Jvscopel27/Water-Tank-monitor/hardware/circuito.png

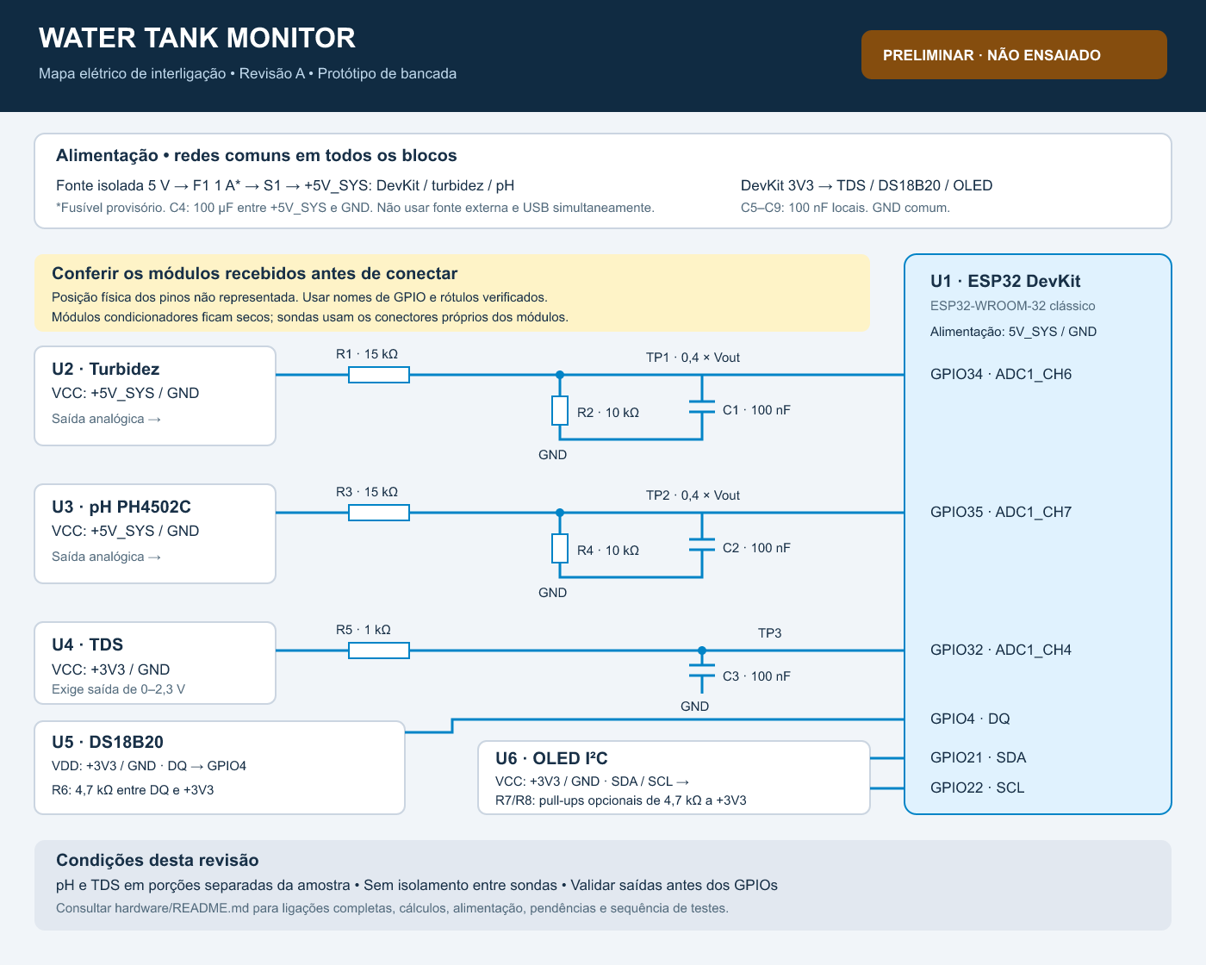
hardware/circuito.png
