Jvscopel27/Water-Tank-monitor/frame/PROJETO PIC.stl

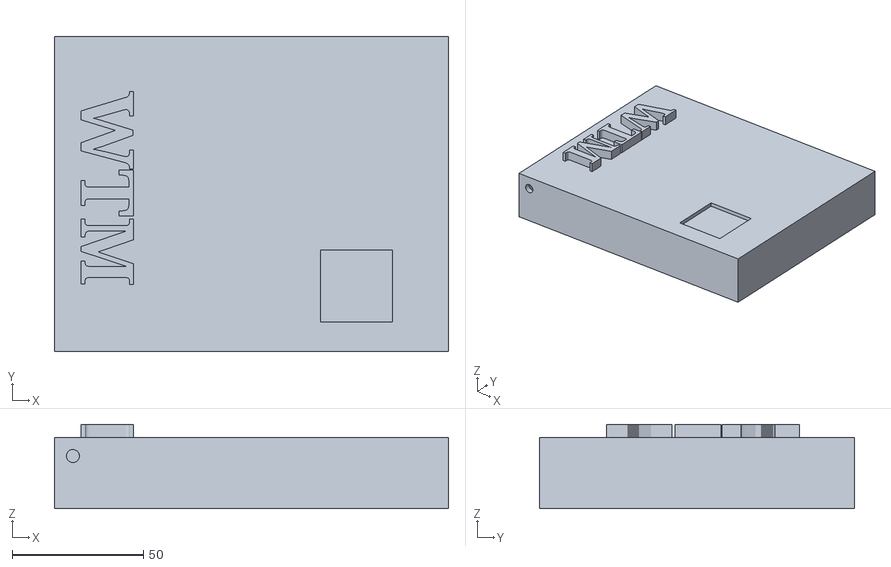
[picture p6: CAD file, 2026-10-22]
frame/PROJETO PIC.stl
150.0 x 120.0 x 32.0
