Jvscopel27/Water-Tank-monitor/Part Studio 1 - tampa.step

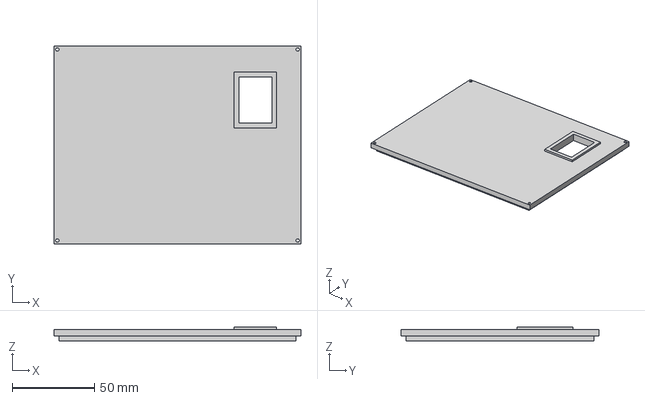
[picture p7: CAD file, 2026-11-10]
Part Studio 1 - tampa.step
150.0 x 120.0 x 8.50 mm
