Jvscopel27/Water-Tank-monitor/Part Studio 1 - caixa.step

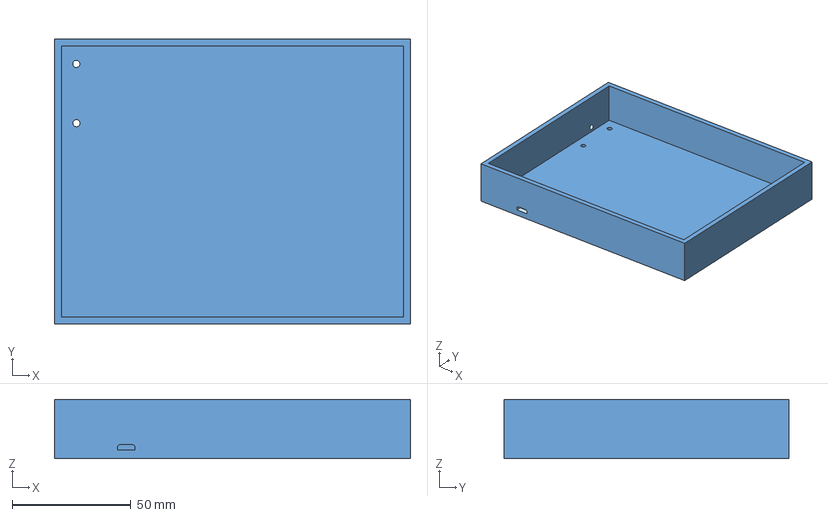
[picture p8: CAD file, 2026-11-10]
Part Studio 1 - caixa.step
150.0 x 120.0 x 25.0 mm
