Jvscopel27/Water-Tank-monitor/frame/Prototipo1.pdf

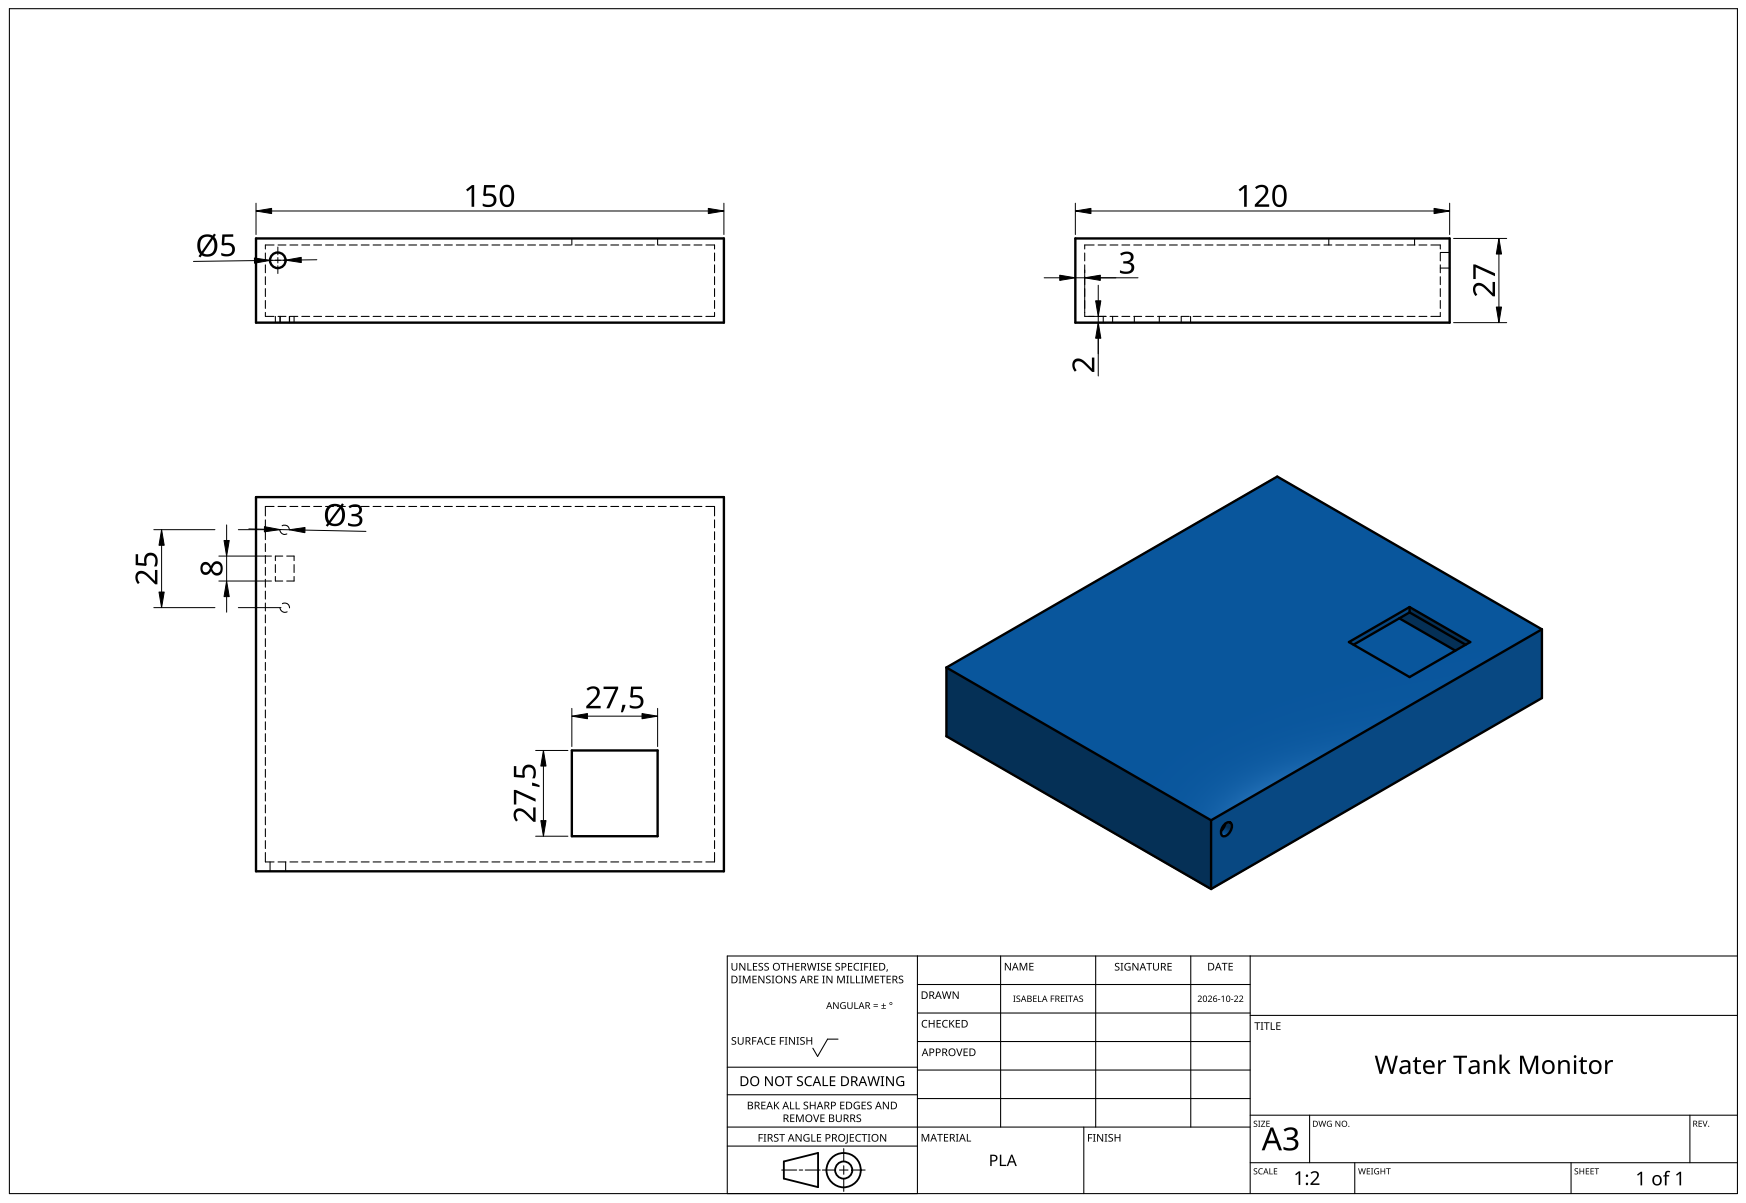
[picture p9: page 1]
