Jvscopel27/Water-Tank-monitor/(commit log)

2026-10-20 docs: add preliminary circuit design and hardware guide
    [bom.csv]
2026-10-22 docs: show supplied Wokwi circuit image in README
2026-10-22 docs: define Arduino stack and organize Wokwi demonstration
2026-10-22 feat: add ESP32 bench firmware with calibration and local dashboard
2026-10-22 Update README with new 'Frame' section and links
    Added a new section 'Frame' to the README and updated links.
2026-10-30 Document setup and code logic; publish dashboard, OLED graphs and guided calibration
